Austayo/SWE300/swe300.kicad_pcb

## KiCad design swe300.kicad_pcb (2025-03-10)

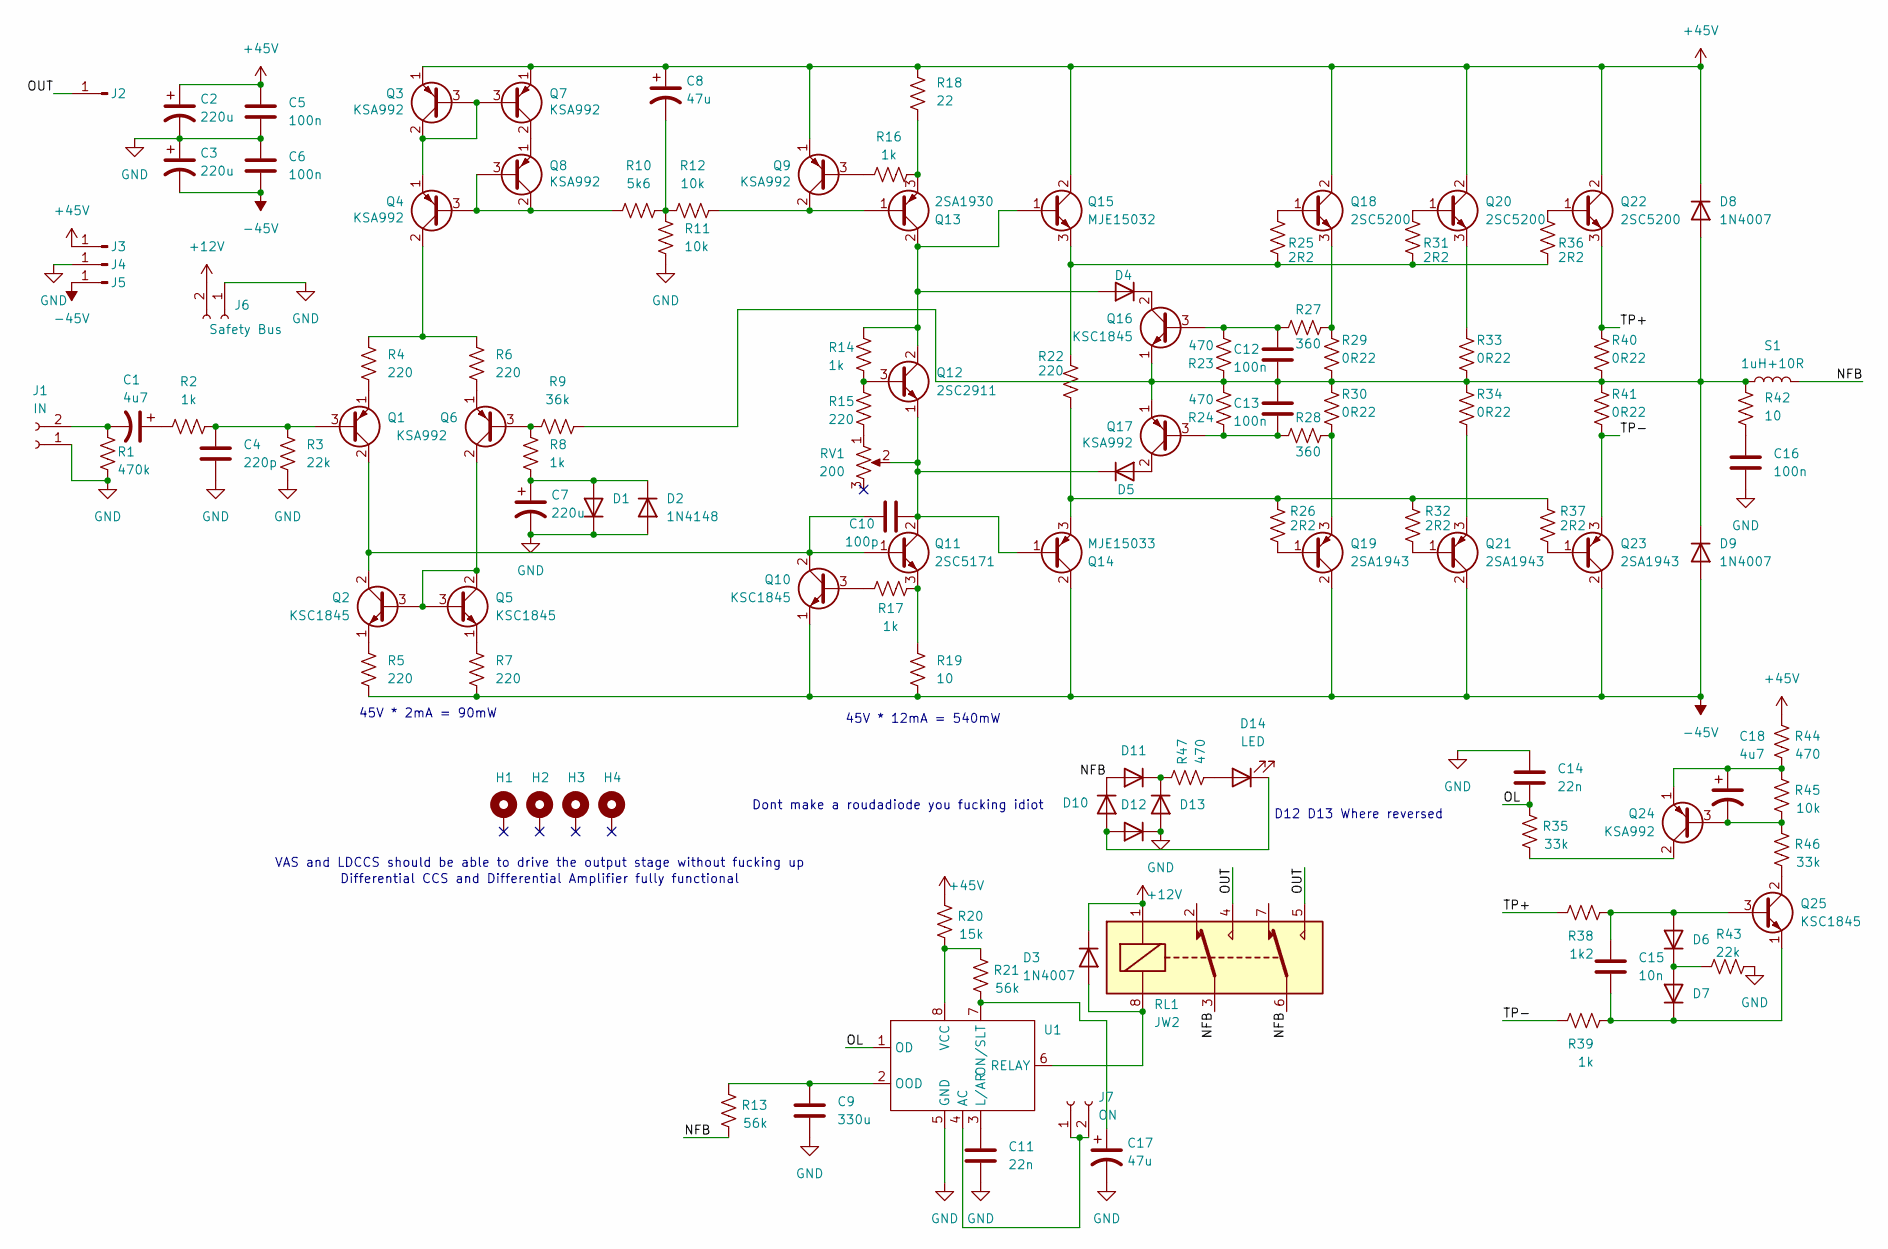
[picture p1: schematic swe300.kicad_sch]

Parts:
C1, C18: 4u7; CP_Radial_D6.3mm_P2.50mm
C2, C3: 220u; CP_Radial_D10.0mm_P5.00mm
C4: 220p; C_Disc_D4.7mm_W2.5mm_P5.00mm
C5, C6, C12, C13, C16: 100n; C_Rect_L7.0mm_W2.0mm_P5.00mm
C7: 220u; CP_Radial_D6.3mm_P2.50mm
C8, C17: 47u; CP_Radial_D6.3mm_P2.50mm
C9: 330u; C_Radial_D8.0mm_H11.5mm_P3.50mm
C10: 100p; C_Disc_D4.7mm_W2.5mm_P5.00mm
C11, C14: 22n; C_Rect_L7.0mm_W2.0mm_P5.00mm
C15: 10n; C_Rect_L7.0mm_W2.0mm_P5.00mm
D1, D2, D4, D5, D6, D7, D10, D11, D12, D13: 1N4148; D_DO-35_SOD27_P7.62mm_Horizontal
D3, D8, D9: 1N4007; D_DO-41_SOD81_P10.16mm_Horizontal
D14: LED; LED_D4.0mm
H1, H2, H3, H4: MountingHole_Pad; MountingHole_3.2mm_M3_DIN965_Pad_TopBottom
J1: IN; PinHeader_1x02_P2.54mm_Vertical
J2, J3, J4, J5: 6.3mm spade
J6: Safety Bus; PinHeader_1x02_P2.54mm_Vertical
J7: ON; PinHeader_1x02_P2.54mm_Vertical
Q1, Q3, Q4, Q6, Q7, Q8, Q9, Q17, Q24: KSA992; TO-92L_Inline_Wide
Q2, Q5, Q10, Q16, Q25: KSC1845; TO-92L_Inline_Wide
Q11: 2SC5171; TO-220-3_Vertical
Q12: 2SC2911; TO-126-3_Horizontal_TabUp
Q13: 2SA1930; TO-220-3_Vertical
Q14: MJE15033; TO-220-3_Horizontal_TabUp
Q15: MJE15032; TO-220-3_Horizontal_TabUp
Q18, Q20, Q22: 2SC5200; TO-264-3_Horizontal_TabUp
Q19, Q21, Q23: 2SA1943; TO-264-3_Horizontal_TabUp
R1: 470k; R_Axial_DIN0207_L6.3mm_D2.5mm_P10.16mm_Horizontal
R2, R8, R14, R16, R17, R39: 1k; R_Axial_DIN0207_L6.3mm_D2.5mm_P10.16mm_Horizontal
R3, R43: 22k; R_Axial_DIN0207_L6.3mm_D2.5mm_P10.16mm_Horizontal
R4, R5, R6, R7, R15, R22: 220; R_Axial_DIN0207_L6.3mm_D2.5mm_P10.16mm_Horizontal
R9: 36k; R_Axial_DIN0207_L6.3mm_D2.5mm_P10.16mm_Horizontal
R10: 5k6; R_Axial_DIN0207_L6.3mm_D2.5mm_P10.16mm_Horizontal
R11, R12, R45: 10k; R_Axial_DIN0207_L6.3mm_D2.5mm_P10.16mm_Horizontal
R13, R21: 56k; R_Axial_DIN0207_L6.3mm_D2.5mm_P10.16mm_Horizontal
R18: 22; R_Axial_DIN0207_L6.3mm_D2.5mm_P10.16mm_Horizontal
R19: 10; R_Axial_DIN0207_L6.3mm_D2.5mm_P10.16mm_Horizontal
R20: 15k; R_Axial_DIN0207_L6.3mm_D2.5mm_P10.16mm_Horizontal
R23, R24, R44, R47: 470; R_Axial_DIN0207_L6.3mm_D2.5mm_P10.16mm_Horizontal
R25, R26, R31, R32, R36, R37: 2R2; R_Axial_DIN0207_L6.3mm_D2.5mm_P10.16mm_Horizontal
R27, R28: 360; R_Axial_DIN0207_L6.3mm_D2.5mm_P10.16mm_Horizontal
R29, R30, R33, R34, R40, R41: 0R22; R_Axial_DIN0922_L20.0mm_D9.0mm_P25.40mm_Horizontal
R35, R46: 33k; R_Axial_DIN0207_L6.3mm_D2.5mm_P10.16mm_Horizontal
R38: 1k2; R_Axial_DIN0207_L6.3mm_D2.5mm_P10.16mm_Horizontal
R42: 10; R_Axial_DIN0309_L9.0mm_D3.2mm_P12.70mm_Horizontal
RL1: JW2; Relay_DPDT_Panasonic_JW2
RV1: 200; Potentiometer_Runtron_RM-063_Horizontal
S1: 1uH+10R; 10mm Snubber
U1: SIP-8_19x3mm_P2.54mm

Connections:
+12V: D3.1 (K), J6.2, RL1.1
+45V: C2.1, C5.1, C8.1, D8.1 (K), J3.1, Q3.1 (E), Q7.1 (E), Q9.1 (E), Q15.2 (C), Q18.2 (C), Q20.2 (C), Q22.2 (C), R18.1, R20.1, R44.1
-45V: C3.2, C6.2, D9.2 (A), J5.1, Q10.1 (E), Q14.2 (C), Q19.2 (C), Q21.2 (C), Q23.2 (C), R5.2, R7.2, R19.2
/NFB: D10.1 (K), D11.2 (A), R13.2, RL1.3, RL1.6, S1.2
/OL: C14.2, R35.1, U1.1 (OD)
/OUT: J2.1, RL1.4, RL1.5
/TP+: Q22.3 (E), R38.2, R40.2
/TP-: Q23.3 (E), R39.2, R41.1
GND: C2.2, C3.1, C4.2, C5.2, C6.1, C7.2, C9.2, C11.2, C14.1, C16.2, C17.2, D1.1 (K), D2.2 (A), D12.1 (K), D13.2 (A), J1.1, J4.1, J6.1, R1.2, R3.1, R11.1, R43.2, U1.5 (GND)
unnamed: C1.1, R2.2
unnamed: C8.2, R10.2, R11.2, R12.2
unnamed: C16.1, R42.2
unnamed: C7.1, D1.2 (A), D2.1 (K), R8.1
unnamed: D3.2 (A), RL1.8, U1.6 (RELAY)
unnamed: D4.2 (A), Q12.2 (C), Q13.2 (C), Q15.1 (B), R14.2
unnamed: D4.1 (K), Q16.2 (C)
unnamed: D5.2 (A), Q17.2 (C)
unnamed: C10.2, D5.1 (K), Q11.2 (C), Q12.1 (E), Q14.1 (B), RV1.2
unnamed: C15.1, D6.2 (A), Q25.3 (B), R38.1
unnamed: D6.1 (K), D7.2 (A), R43.1
unnamed: C15.2, D7.1 (K), Q25.1 (E), R39.1
unnamed: C12.1, C13.2, D8.2 (A), D9.1 (K), Q16.1 (E), Q17.1 (E), R9.1, R23.1, R24.2, R29.1, R30.2, R33.1, R34.2, R40.1, R41.2, R42.1, S1.1
unnamed: D10.2 (A), D12.2 (A), D14.1 (K)
unnamed: D11.1 (K), D13.1 (K), R47.1
unnamed: D14.2 (A), R47.2
unnamed: C1.2, J1.2, R1.1
unnamed: J7.1, J7.2, U1.4 (AC)
unnamed: C4.1, Q1.3 (B), R2.1, R3.2
unnamed: C10.1, Q1.2 (C), Q2.2 (C), Q10.2 (C), Q11.1 (B)
unnamed: Q1.1 (E), R4.2
unnamed: Q2.3 (B), Q5.2 (C), Q5.3 (B), Q6.2 (C)
unnamed: Q2.1 (E), R5.1
unnamed: Q3.2 (C), Q3.3 (B), Q4.1 (E), Q7.3 (B)
unnamed: Q4.3 (B), Q8.2 (C), Q8.3 (B), R10.1
unnamed: Q4.2 (C), R4.1, R6.1
unnamed: Q5.1 (E), R7.1
unnamed: Q6.3 (B), R8.2, R9.2
unnamed: Q6.1 (E), R6.2
unnamed: Q7.2 (C), Q8.1 (E)
unnamed: Q9.3 (B), R16.2
unnamed: Q10.3 (B), R17.1
unnamed: Q11.3 (E), R17.2, R19.1
unnamed: Q12.3 (B), R14.1, R15.2
unnamed: Q9.2 (C), Q13.1 (B), R12.1
unnamed: Q13.3 (E), R16.1, R18.2
unnamed: Q14.3 (E), R22.1, R26.2, R32.2, R37.2
unnamed: Q15.3 (E), R22.2, R25.1, R31.1, R36.1
unnamed: C12.2, Q16.3 (B), R23.2, R27.2
unnamed: C13.1, Q17.3 (B), R24.1, R28.2
unnamed: Q18.1 (B), R25.2
unnamed: Q18.3 (E), R27.1, R29.2
unnamed: Q19.1 (B), R26.1
unnamed: Q19.3 (E), R28.1, R30.1
unnamed: Q20.1 (B), R31.2
unnamed: Q20.3 (E), R33.2
unnamed: Q21.1 (B), R32.1
unnamed: Q21.3 (E), R34.1
unnamed: Q22.1 (B), R36.2
unnamed: Q23.1 (B), R37.1
unnamed: C18.2, Q24.3 (B), R45.2, R46.1
unnamed: Q24.2 (C), R35.2
unnamed: C18.1, Q24.1 (E), R44.2, R45.1
unnamed: Q25.2 (C), R46.2
unnamed: R15.1, RV1.1
unnamed: C11.1, U1.3 (L/AR)
unnamed: C17.1, R21.2, U1.7 (ON/SLT)
unnamed: C9.1, R13.1, U1.2 (OOD)
unnamed: R20.2, R21.1, U1.8 (VCC)

Notes on the sheet:
45V * 12mA = 540mW
D12 D13 Where reversed
VAS and LDCCS should be able to drive the output stage without fucking up
45V * 2mA = 90mW
Dont make a roudadiode you fucking idiot
Differential CCS and Differential Amplifier fully functional

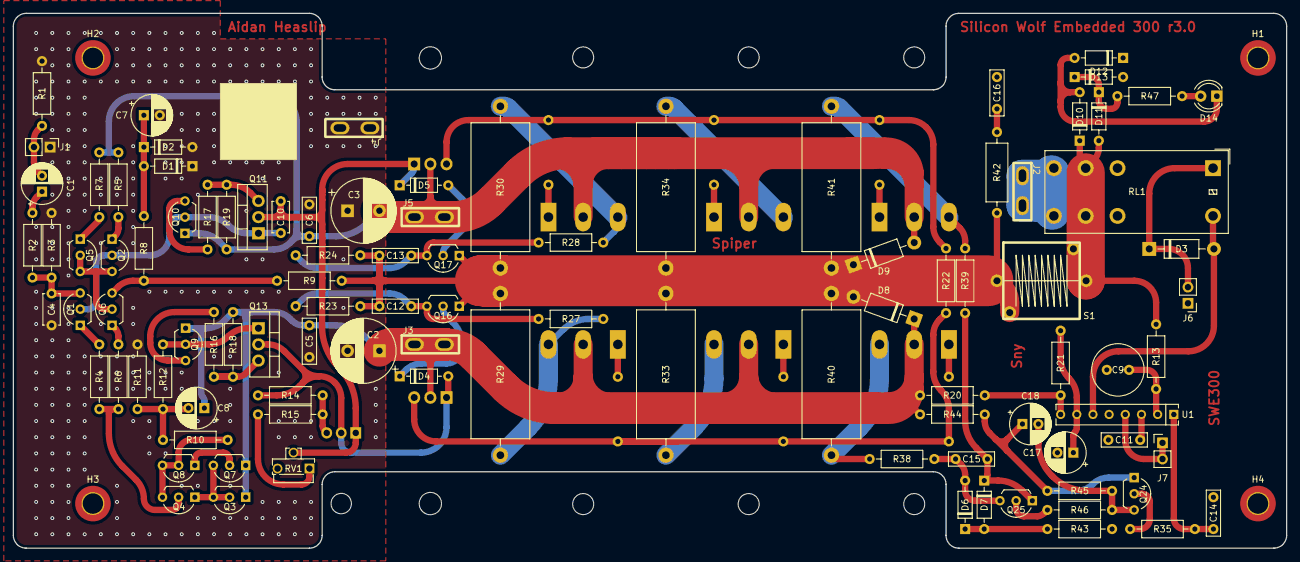
[picture p2: board swe300.kicad_pcb from above]

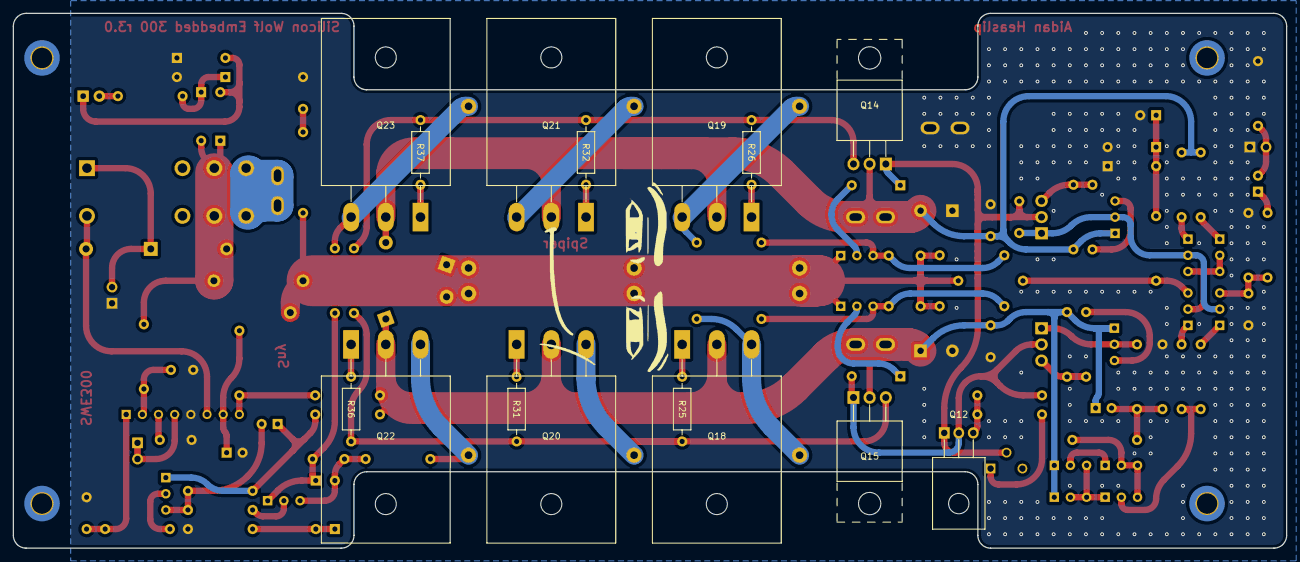
[picture p3: board swe300.kicad_pcb from below]

Board: 2 copper layers, 200.0 x 84.0 mm, 119 parts (15 on the bottom side), 68 nets.
